vincentchen18/nibble/Kicad Files/Kicad Files.kicad_pcb

## KiCad design Kicad Files/Kicad Files.kicad_pcb (2026-11-08)

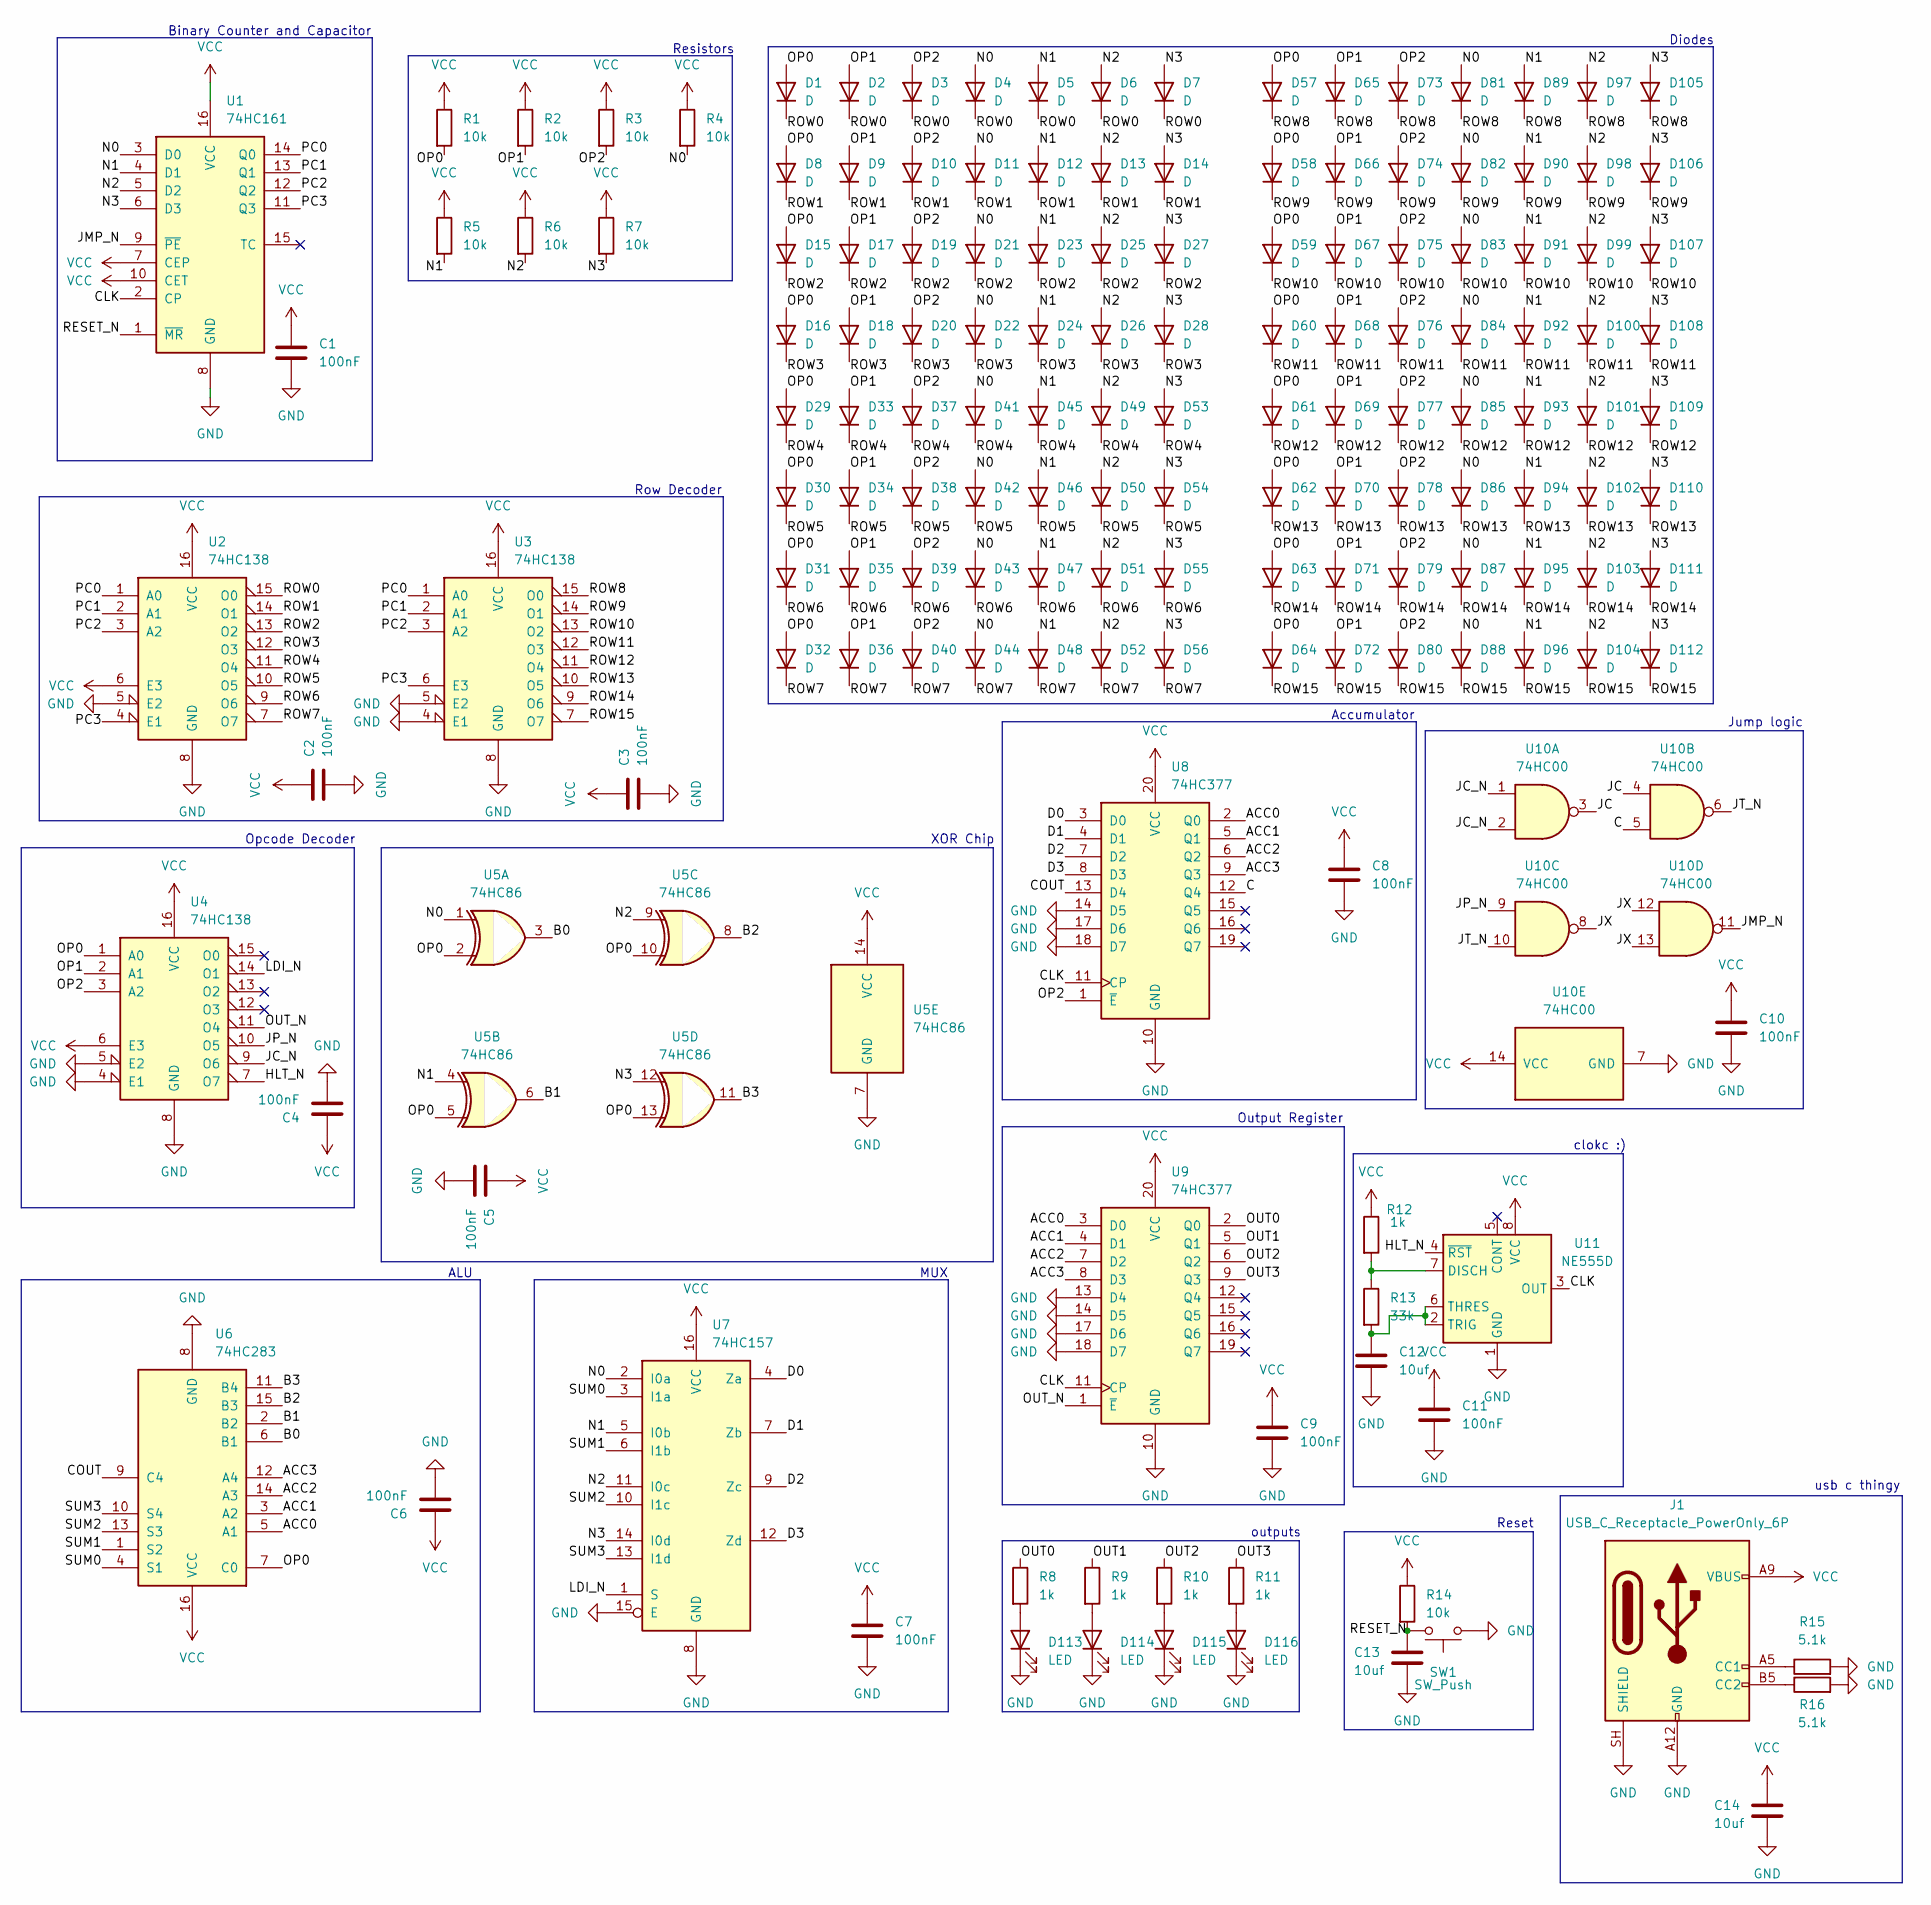
[picture p4: schematic Kicad Files.kicad_sch]

Parts:
C1, C2, C3, C4, C5, C6, C7, C8, C9, C10, C11: 100nF; C_0603_1608Metric
C12, C13, C14: 10uf; C_0805_2012Metric
D1, D2, D3, D4, D5, D6, D7, D8, D9, D10, D11, D12, D13, D14, D15, D16, D17, D18, D19, D20, D21, D22, D23, D24, D25, D26, D27, D28, D29, D30, D31, D32, D33, D34, D35, D36, D37, D38, D39, D40, D41, D42, D43, D44, D45, D46, D47, D48, D49, D50, D51, D52, D53, D54, D55, D56, D57, D58, D59, D60, D61, D62, D63, D64, D65, D66, D67, D68, D69, D70, D71, D72, D73, D74, D75, D76, D77, D78, D79, D80, D81, D82, D83, D84, D85, D86, D87, D88, D89, D90, D91, D92, D93, D94, D95, D96, D97, D98, D99, D100, D101, D102, D103, D104, D105, D106, D107, D108, D109, D110, D111, D112: D; D_SOD-123
D113, D114, D115, D116: LED; LED_0603_1608Metric
J1: USB_C_Receptacle_PowerOnly_6P; USB_C_Receptacle_GCT_USB4125-xx-x_6P_TopMnt_Horizontal
R1, R2, R3, R4, R5, R6, R7, R14: 10k; R_0603_1608Metric
R8, R9, R10, R11, R12: 1k; R_0603_1608Metric
R13: 33k; R_0603_1608Metric
R15, R16: 5.1k; R_0603_1608Metric
SW1: SW_Push; SW_PUSH_6mm
U1: 74HC161; SOIC-16_3.9x9.9mm_P1.27mm
U2, U3, U4: 74HC138; SOIC-16_3.9x9.9mm_P1.27mm
U5: 74HC86; SOIC-14_3.9x8.7mm_P1.27mm
U6: 74HC283; SOIC-16_3.9x9.9mm_P1.27mm
U7: 74HC157; SOIC-16_3.9x9.9mm_P1.27mm
U8, U9: 74HC377; SOIC-20W_7.5x12.8mm_P1.27mm
U10: 74HC00; SOIC-14_3.9x8.7mm_P1.27mm
U11: NE555D; SOIC-8_3.9x4.9mm_P1.27mm

Connections:
/ACC0: U6.5 (A1), U8.2 (Q0), U9.3 (D0)
/ACC1: U6.3 (A2), U8.5 (Q1), U9.4 (D1)
/ACC2: U6.14 (A3), U8.6 (Q2), U9.7 (D2)
/ACC3: U6.12 (A4), U8.9 (Q3), U9.8 (D3)
/B0: U5.3, U6.6 (B1)
/B1: U5.6, U6.2 (B2)
/B2: U5.8, U6.15 (B3)
/B3: U5.11, U6.11 (B4)
/C: U8.12 (Q4), U10.5
/CLK: U1.2 (CP), U8.11 (CP), U9.11 (CP), U11.3 (OUT)
/COUT: U6.9 (C4), U8.13 (D4)
/D0: U7.4 (Za), U8.3 (D0)
/D1: U7.7 (Zb), U8.4 (D1)
/D2: U7.9 (Zc), U8.7 (D2)
/D3: U7.12 (Zd), U8.8 (D3)
/HLT_N: U4.7 (O7), U11.4 (~RST)
/JC: U10.3, U10.4
/JC_N: U4.9 (O6), U10.1, U10.2
/JMP_N: U1.9 (~PE), U10.11
/JP_N: U4.10 (O5), U10.9
/JT_N: U10.6, U10.10
/JX: U10.8, U10.12, U10.13
/LDI_N: U4.14 (O1), U7.1 (S)
/N0: D4.2 (A), D11.2 (A), D21.2 (A), D22.2 (A), D41.2 (A), D42.2 (A), D43.2 (A), D44.2 (A), D81.2 (A), D82.2 (A), D83.2 (A), D84.2 (A), D85.2 (A), D86.2 (A), D87.2 (A), D88.2 (A), R4.2, U1.3 (D0), U5.1, U7.2 (I0a)
/N1: D5.2 (A), D12.2 (A), D23.2 (A), D24.2 (A), D45.2 (A), D46.2 (A), D47.2 (A), D48.2 (A), D89.2 (A), D90.2 (A), D91.2 (A), D92.2 (A), D93.2 (A), D94.2 (A), D95.2 (A), D96.2 (A), R5.2, U1.4 (D1), U5.4, U7.5 (I0b)
/N2: D6.2 (A), D13.2 (A), D25.2 (A), D26.2 (A), D49.2 (A), D50.2 (A), D51.2 (A), D52.2 (A), D97.2 (A), D98.2 (A), D99.2 (A), D100.2 (A), D101.2 (A), D102.2 (A), D103.2 (A), D104.2 (A), R6.2, U1.5 (D2), U5.9, U7.11 (I0c)
/N3: D7.2 (A), D14.2 (A), D27.2 (A), D28.2 (A), D53.2 (A), D54.2 (A), D55.2 (A), D56.2 (A), D105.2 (A), D106.2 (A), D107.2 (A), D108.2 (A), D109.2 (A), D110.2 (A), D111.2 (A), D112.2 (A), R7.2, U1.6 (D3), U5.12, U7.14 (I0d)
/OP0: D1.2 (A), D8.2 (A), D15.2 (A), D16.2 (A), D29.2 (A), D30.2 (A), D31.2 (A), D32.2 (A), D57.2 (A), D58.2 (A), D59.2 (A), D60.2 (A), D61.2 (A), D62.2 (A), D63.2 (A), D64.2 (A), R1.2, U4.1 (A0), U5.2, U5.5, U5.10, U5.13, U6.7 (C0)
/OP1: D2.2 (A), D9.2 (A), D17.2 (A), D18.2 (A), D33.2 (A), D34.2 (A), D35.2 (A), D36.2 (A), D65.2 (A), D66.2 (A), D67.2 (A), D68.2 (A), D69.2 (A), D70.2 (A), D71.2 (A), D72.2 (A), R2.2, U4.2 (A1)
/OP2: D3.2 (A), D10.2 (A), D19.2 (A), D20.2 (A), D37.2 (A), D38.2 (A), D39.2 (A), D40.2 (A), D73.2 (A), D74.2 (A), D75.2 (A), D76.2 (A), D77.2 (A), D78.2 (A), D79.2 (A), D80.2 (A), R3.2, U4.3 (A2), U8.1 (~E)
/OUT0: R8.1, U9.2 (Q0)
/OUT1: R9.1, U9.5 (Q1)
/OUT2: R10.1, U9.6 (Q2)
/OUT3: R11.1, U9.9 (Q3)
/OUT_N: U4.11 (O4), U9.1 (~E)
/PC0: U1.14 (Q0), U2.1 (A0), U3.1 (A0)
/PC1: U1.13 (Q1), U2.2 (A1), U3.2 (A1)
/PC2: U1.12 (Q2), U2.3 (A2), U3.3 (A2)
/PC3: U1.11 (Q3), U2.4 (E1), U3.6 (E3)
/RESET_N: C13.1, R14.2, SW1.2, U1.1 (~MR)
/ROW0: D1.1 (K), D2.1 (K), D3.1 (K), D4.1 (K), D5.1 (K), D6.1 (K), D7.1 (K), U2.15 (O0)
/ROW1: D8.1 (K), D9.1 (K), D10.1 (K), D11.1 (K), D12.1 (K), D13.1 (K), D14.1 (K), U2.14 (O1)
/ROW2: D15.1 (K), D17.1 (K), D19.1 (K), D21.1 (K), D23.1 (K), D25.1 (K), D27.1 (K), U2.13 (O2)
/ROW3: D16.1 (K), D18.1 (K), D20.1 (K), D22.1 (K), D24.1 (K), D26.1 (K), D28.1 (K), U2.12 (O3)
/ROW4: D29.1 (K), D33.1 (K), D37.1 (K), D41.1 (K), D45.1 (K), D49.1 (K), D53.1 (K), U2.11 (O4)
/ROW5: D30.1 (K), D34.1 (K), D38.1 (K), D42.1 (K), D46.1 (K), D50.1 (K), D54.1 (K), U2.10 (O5)
/ROW6: D31.1 (K), D35.1 (K), D39.1 (K), D43.1 (K), D47.1 (K), D51.1 (K), D55.1 (K), U2.9 (O6)
/ROW7: D32.1 (K), D36.1 (K), D40.1 (K), D44.1 (K), D48.1 (K), D52.1 (K), D56.1 (K), U2.7 (O7)
/ROW8: D57.1 (K), D65.1 (K), D73.1 (K), D81.1 (K), D89.1 (K), D97.1 (K), D105.1 (K), U3.15 (O0)
/ROW9: D58.1 (K), D66.1 (K), D74.1 (K), D82.1 (K), D90.1 (K), D98.1 (K), D106.1 (K), U3.14 (O1)
/ROW10: D59.1 (K), D67.1 (K), D75.1 (K), D83.1 (K), D91.1 (K), D99.1 (K), D107.1 (K), U3.13 (O2)
/ROW11: D60.1 (K), D68.1 (K), D76.1 (K), D84.1 (K), D92.1 (K), D100.1 (K), D108.1 (K), U3.12 (O3)
/ROW12: D61.1 (K), D69.1 (K), D77.1 (K), D85.1 (K), D93.1 (K), D101.1 (K), D109.1 (K), U3.11 (O4)
/ROW13: D62.1 (K), D70.1 (K), D78.1 (K), D86.1 (K), D94.1 (K), D102.1 (K), D110.1 (K), U3.10 (O5)
/ROW14: D63.1 (K), D71.1 (K), D79.1 (K), D87.1 (K), D95.1 (K), D103.1 (K), D111.1 (K), U3.9 (O6)
/ROW15: D64.1 (K), D72.1 (K), D80.1 (K), D88.1 (K), D96.1 (K), D104.1 (K), D112.1 (K), U3.7 (O7)
/SUM0: U6.4 (S1), U7.3 (I1a)
/SUM1: U6.1 (S2), U7.6 (I1b)
/SUM2: U6.13 (S3), U7.10 (I1c)
/SUM3: U6.10 (S4), U7.13 (I1d)
GND: C1.2, C2.2, C3.2, C4.2, C5.2, C6.2, C7.2, C8.2, C9.2, C10.2, C11.2, C12.2, C13.2, C14.2, D113.1 (K), D114.1 (K), D115.1 (K), D116.1 (K), J1.A12 (GND), J1.B12 (GND), J1.SH (SHIELD), R15.2, R16.2, SW1.1, U1.8 (GND), U2.5 (E2), U2.8 (GND), U3.4 (E1), U3.5 (E2), U3.8 (GND), U4.4 (E1), U4.5 (E2), U4.8 (GND), U5.7 (GND), U6.8 (GND), U7.8 (GND), U7.15 (E), U8.10 (GND), U8.14 (D5), U8.17 (D6), U8.18 (D7), U9.10 (GND), U9.13 (D4), U9.14 (D5), U9.17 (D6), U9.18 (D7), U10.7 (GND), U11.1 (GND)
unnamed: D113.2 (A), R8.2
unnamed: D114.2 (A), R9.2
unnamed: D115.2 (A), R10.2
unnamed: D116.2 (A), R11.2
unnamed: J1.A5 (CC1), R15.1
unnamed: J1.B5 (CC2), R16.1
unnamed: R12.2, R13.1, U11.7 (DISCH)
unnamed: C12.1, R13.2, U11.2 (TRIG), U11.6 (THRES)
VCC: C1.1, C2.1, C3.1, C4.1, C5.1, C6.1, C7.1, C8.1, C9.1, C10.1, C11.1, C14.1, J1.A9 (VBUS), J1.B9 (VBUS), R1.1, R2.1, R3.1, R4.1, R5.1, R6.1, R7.1, R12.1, R14.1, U1.7 (CEP), U1.10 (CET), U1.16 (VCC), U2.6 (E3), U2.16 (VCC), U3.16 (VCC), U4.6 (E3), U4.16 (VCC), U5.14 (VCC), U6.16 (VCC), U7.16 (VCC), U8.20 (VCC), U9.20 (VCC), U10.14 (VCC), U11.8 (VCC)

Notes on the sheet:
Accumulator
Jump logic
Binary Counter and Capacitor
Reset
Diodes
usb c thingy
Resistors
Output Register
MUX
XOR Chip
outputs
clokc :)
Row Decoder
Opcode Decoder
ALU

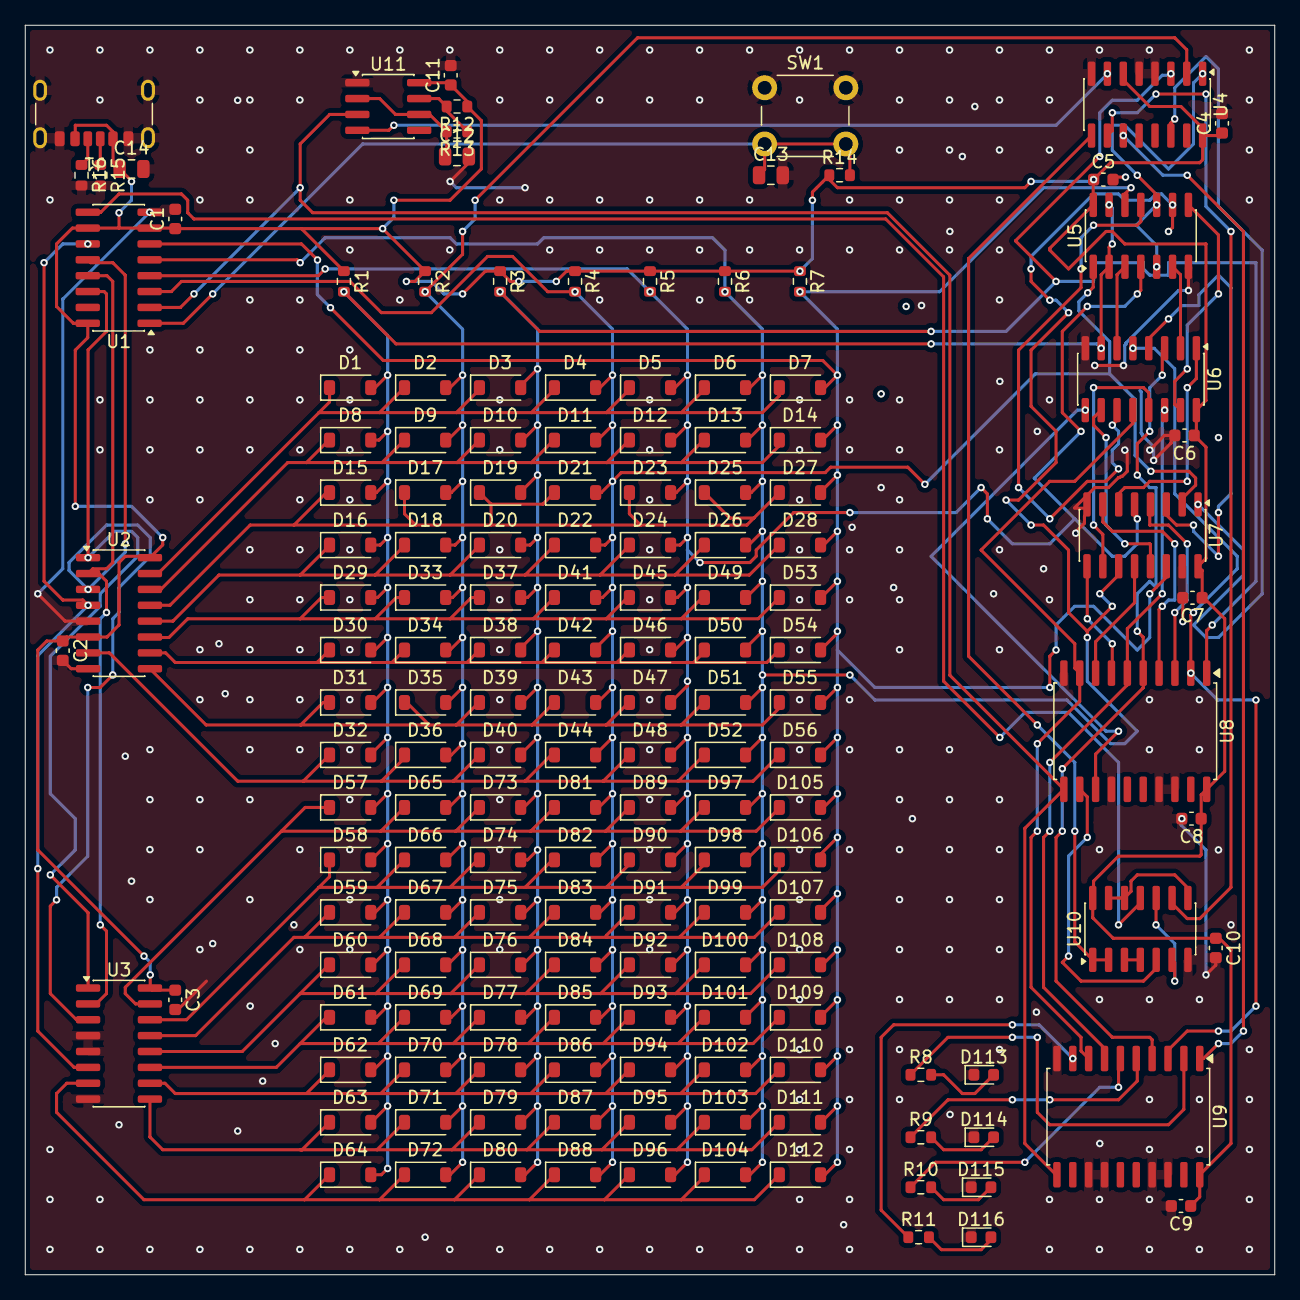
[picture p5: board Kicad Files.kicad_pcb from above]

Board: 2 copper layers, 100.0 x 100.0 mm, 159 parts (0 on the bottom side), 70 nets.
