vincentchen18/nibble/Journal/img.png

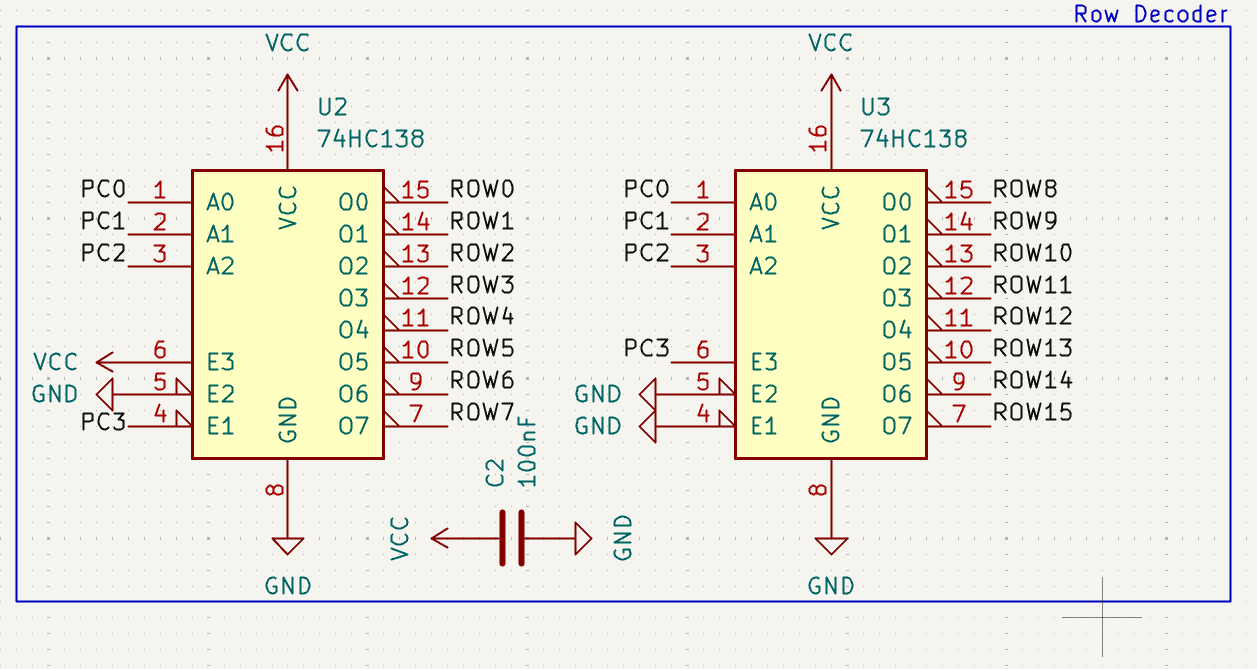
Journal/img.png
