vincentchen18/nibble/Journal/img_1.png

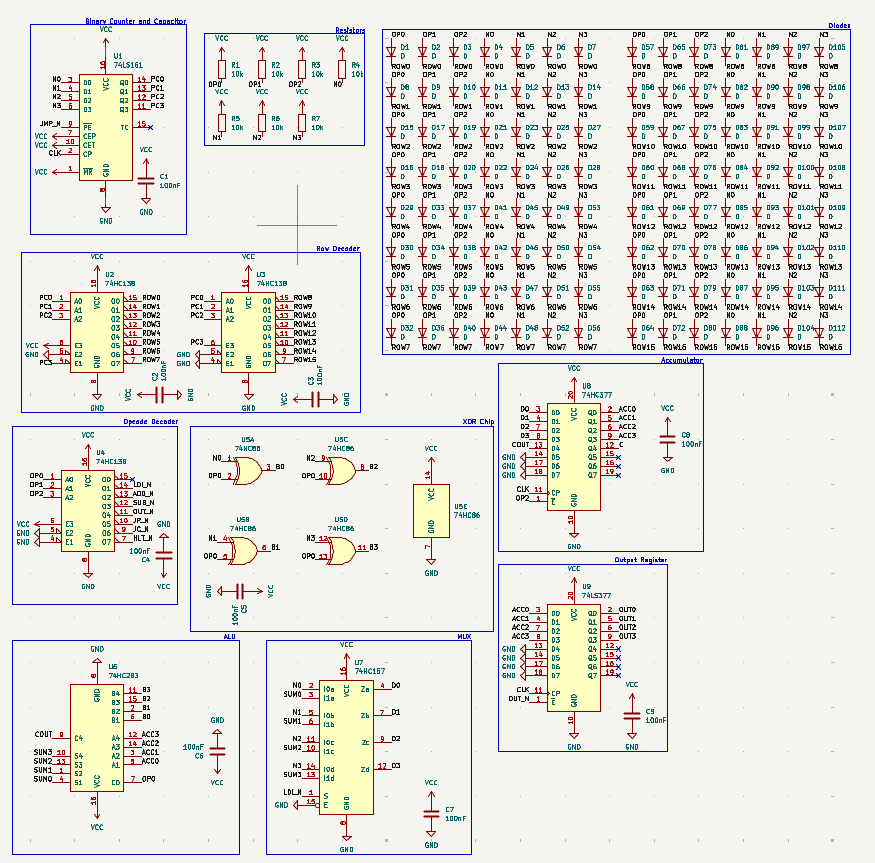
Journal/img_1.png
