vincentchen18/nibble/Journal/img_2.png

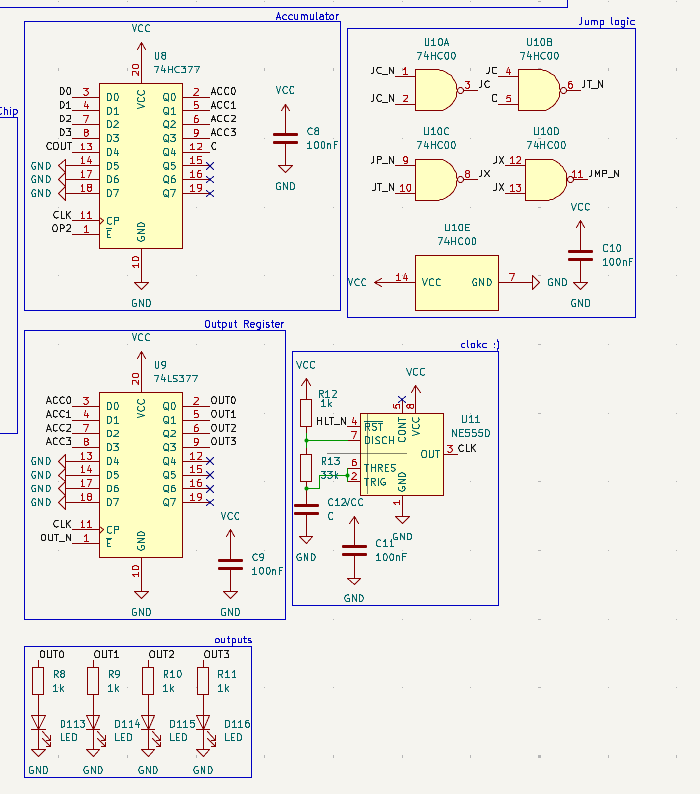
Journal/img_2.png
