vincentchen18/nibble/Journal/img_4.png

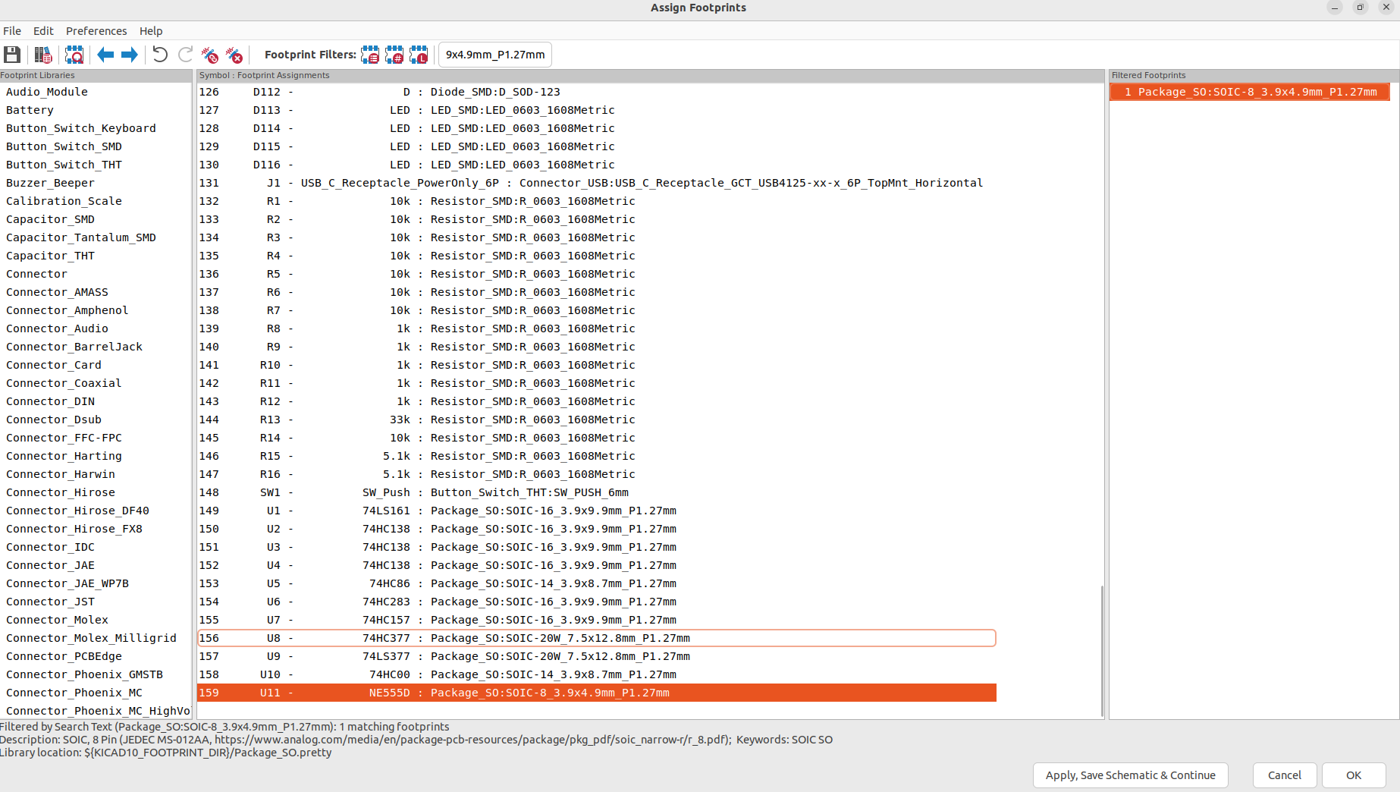
Journal/img_4.png
