vincentchen18/nibble/(commit log)

2026-11-02 schematics for 9 chips + Rs + diodes
    [Kicad Files.kicad_pcb, Kicad Files.kicad_sch]
2026-11-02 Sync Nibble from Half Life
    [BOM.csv]
2026-11-07 finish footprints and schematic
    [Kicad Files.kicad_sch]
2026-11-08 gerbers + wiring fixing + readme
    [Kicad Files-B_Cu.gbr, Kicad Files-B_Mask.gbr, Kicad Files-B_Paste.gbr, Kicad Files-B_Silkscreen.gbr, Kicad Files-Edge_Cuts.gbr, Kicad Files-F_Cu.gbr, Kicad Files-F_Mask.gbr, Kicad Files-F_Paste.gbr]
2026-11-08 i hate half life bom import
    [BOM.csv]
